jcollinsnw/CANoE/canoe/can_protocol.h

// can_protocol.h
// Shared CAN message layout for the accessory bus.
// Copy this same file into every node's sketch folder so both sides agree.
//
// Bus: 125 kbit/s, standard 11-bit IDs. Low speed gives us noise margin in
// bench mode (open-drain + pull-up) and still runs fine through real
// transceivers in the car. Bump to 250 or 500 kbit/s later if you want.

#pragma once
#include <stdint.h>

// --------------------------------------------------------------
// Message IDs
// --------------------------------------------------------------
#define CAN_ID_RELAY_CMD         0x100  // Switch panel  -> Relay controller
#define CAN_ID_RELAY_STATUS      0x101  // Relay ctrl    -> everyone, periodic
#define CAN_ID_LED_CMD           0x102  // Any node -> target node: [target, mask, state]
#define CAN_ID_LED_STATUS        0x103  // Target node  -> everyone, on change: [node_id, bitmap]
#define CAN_ID_BUZZER_CMD        0x104  // Any node -> target node: [target, cmd, arg0]
                                        //   target: node_id or 0xFF (broadcast)
                                        //   cmd: BUZZER_SEQ_* or BUZZER_CMD_MUTE
                                        //   arg0: seq argument (peer count for BUZZER_SEQ_PEER;
                                        //         1/0 for BUZZER_CMD_MUTE)
#define CAN_ID_SWITCH_EVENT      0x200  // Switch panel  -> everyone, on change
#define CAN_ID_SWITCH_ACK        0x202  // Any non-originating node -> switch panel: [switch_id, event]
#define CAN_ID_ENCODER_EVENT     0x201  // Switch panel  -> everyone: rotary encoder
#define CAN_ID_TELEMETRY         0x300  // Relay ctrl    -> everyone, periodic
#define CAN_ID_ENV_DATA          0x301  // Switch panel  -> everyone, periodic (temp/humidity)
#define CAN_ID_IMU_DATA          0x302  // Viper iface   -> everyone, periodic (accel xyz)
#define CAN_ID_SHAKE_EVENT       0x303  // Viper iface   -> everyone, on detection
#define CAN_ID_ENGINE_DATA       0x304  // RPM node      -> everyone: [rpm_lo, rpm_hi]
#define CAN_ID_GPS_DATA          0x305  // GPS node      -> everyone: [speed_lo, speed_hi, heading_lo, heading_hi, flags]

#define CAN_ID_WBO2_DATA         0x306  // WBO2 node     -> everyone: [afr_lo, afr_hi] (AFR × 100)

#define CAN_ID_ECU_DATA          0x307  // ECU node      -> everyone, 250 ms:
                                        //   [0] mode (0=carb, 1=inject)
                                        //   [1] MAP kPa  (0–255)
                                        //   [2] TPS %    (0–100)
                                        //   [3] CLT °C + 40  (0 = −40°C)
                                        //   [4] IAT °C + 40
                                        //   [5] pw_lo — solenoid duty×100 or inj PW μs (uint16 LE)
                                        //   [6] pw_hi
                                        //   [7] flags: bit0=closed_loop, bit1=enriching,
                                        //              bit2=inj_saturated, bit3=running
#define CAN_ID_ECU_CMD           0x308  // Any node      -> ECU: [cmd, arg0, arg1, arg2]
                                        //   cmd 0x01: set mode   (arg0: 0=carb 1=inject)
                                        //   cmd 0x02: set target AFR×100 (arg1+arg2 = uint16 LE)
                                        //   cmd 0x03: fuel cut   (arg0: 0=off 1=on)
                                        //   cmd 0x04: reset fuel trim
#define CAN_ID_IGNITION_DATA     0x310  // Ignition node -> everyone:
                                        //   [0] coil_cv_lo  (uint16 LE centivolts)
                                        //   [1] coil_cv_hi
                                        //   [2] ign_on      (1 = coil > on-threshold, 0 = below off-threshold)
#define CAN_ID_FUEL_PUMP_STATE   0x311  // Fuel pump node -> everyone:
                                        //   [0] state    (0=PRIME, 1=ARMED, 2=RUNNING)
                                        //   [1] mode     (FuelPumpMode bitmask)
                                        //   [2] reason   (0=none, 1=boot, 2=prime_done, 3=gate_pass,
                                        //                 4=stall, 5=mode_change, 6=re_enable)
                                        //   [3] gates_ok (bit 0=RPM ok, bit 1=COIL ok)

// Node presence heartbeat — every node broadcasts this every 5 s.
// data[0]=node_id, data[1]=peer_count, data[2]=can_ok (0/1)
// The web UI uses data[0] to identify the sender so all nodes share one CAN ID.
#define CAN_ID_NODE_ANNOUNCE     0x0F0

// Boot event — emitted once at the end of setup(), self-echoed back into rx.
// data[0]=node_id. Use TRIG_BOOT() in RULES_DEFAULT_INIT to fire rules on startup.
#define CAN_ID_BOOT_EVENT        0x0F1

// Node capability advertisement — every node broadcasts at boot and on NODE_CAP_REQ.
// data[0]=node_id, data[1]=caps_bitmask, data[2]=switch_count, data[3]=button_count,
// data[4]=led_count, data[5]=relay_count
#define CAN_ID_NODE_CAP          0x0F2
// Node capability request — any node replies with CAN_ID_NODE_CAP.
// data[0]=target_node_id (0xFF = all nodes)
#define CAN_ID_NODE_CAP_REQ      0x0F3

// Reboot command — any node may send; target restarts when its node_id matches or target is 0xFF.
// data[0] = target_node_id (0x01–0x04 for a specific node, 0xFF = all nodes)
#define CAN_ID_REBOOT_CMD        0x0F5

// Unified error event — any module may emit to signal an abnormal condition.
// Receivers (buzzer, LEDs, Cardputer, web UI) react based on severity.
// data[0] = source_node_id
// data[1] = error_code (ERR_*)
// data[2] = severity (ERR_SEV_*)
// data[3] = target_node_id (0xFF = all nodes should alert; specific = only that node alerts)
// data[4] = flags (ERR_FLAG_*)
// data[5] = arg0 (error-specific context)
// data[6] = arg1
// data[7] = arg2
#define CAN_ID_ERROR_EVENT       0x0F6

// Bus error event — emitted by any node that detects a CAN error condition.
// Sent on both transports (ESP-NOW carries it even if wired CAN is failing).
// data[0]=node_id, data[1]=error_code (BUS_ERR_*), data[2]=tx_err_cnt, data[3]=rx_err_cnt
#define CAN_ID_BUS_ERROR         0x0F4

// Bus error codes for CAN_ID_BUS_ERROR data[1]
#define BUS_ERR_BUS_OFF          0x01  // TWAI entered bus-off state; recovery initiated
#define BUS_ERR_ERROR_PASSIVE    0x02  // TEC or REC >= 96 (error passive threshold)
#define BUS_ERR_TX_FAIL          0x03  // 5+ consecutive TX failures (no ACK)
#define BUS_ERR_RX_OVERFLOW      0x04  // RX buffer overrun — frames were silently dropped

// --------------------------------------------------------------
// ERROR_EVENT severity levels
// --------------------------------------------------------------
#define ERR_SEV_INFO             0x00  // transient, usually self-resolving (e.g. sensor glitch)
#define ERR_SEV_WARNING          0x01  // degraded operation, needs attention soon
#define ERR_SEV_CRITICAL         0x02  // hardware damage risk or safety system engaged
#define ERR_SEV_EMERGENCY        0x03  // system inoperable or imminent danger

// ERROR_EVENT flags (data[4])
#define ERR_FLAG_ACTIVE          0x01  // 1 = fault active; 0 = fault cleared
#define ERR_FLAG_AUDIBLE         0x02  // request audible alert on receiver
#define ERR_FLAG_VISUAL          0x04  // request visual alert (LED flash / screen)
#define ERR_FLAG_LATCHING        0x08  // stays active until explicit clear frame received

// ERROR_EVENT error codes (data[1])
// Grouped by subsystem: 0x01–0x1F bus/transport, 0x20–0x3F power,
//                       0x40–0x5F engine/fuel, 0x60–0x7F sensors,
//                       0x80–0x9F comms, 0xA0+ application
// -- Bus / transport --
#define ERR_CAN_INIT_FAIL        0x01  // CAN driver could not start
#define ERR_CAN_BUS_OFF          0x02  // TWAI bus-off state
#define ERR_CAN_ERROR_PASSIVE    0x03  // TWAI error-passive threshold
#define ERR_CAN_TX_FAIL          0x04  // repeated TX failures
#define ERR_CAN_RX_OVERFLOW      0x05  // RX ring overflow, frames lost
#define ERR_ESPNOW_INIT_FAIL     0x06  // ESP-NOW could not initialize
// -- Power --
#define ERR_LOW_VOLTAGE          0x20  // battery below threshold; arg0 = which bat (0=primary, 1=aux)
#define ERR_RELAY_WATCHDOG       0x21  // relay forced off by watchdog; arg0 = relay index
// -- Engine / fuel --
#define ERR_FUEL_PUMP_STALL      0x40  // fuel pump FSM cut (RUNNING→ARMED); arg0 = stall reason
#define ERR_INJECTOR_SATURATED   0x41  // injector duty >95%; arg0 = duty % clamped
#define ERR_WBO2_SENSOR_FAULT    0x42  // WBO2 reading implausible (0V or 5V); arg0 = raw ADC byte
#define ERR_ECU_SENSOR_FAULT     0x43  // NTC/MAP/TPS out of range; arg0 = sensor id (0=MAP,1=TPS,2=CLT,3=IAT)
// -- Sensors --
#define ERR_MPU6050_FAIL         0x60  // IMU not responding
#define ERR_DHT22_FAIL           0x61  // temp/humidity read failed; arg0 = consecutive fail count
#define ERR_GPS_NO_FIX           0x62  // GPS has no fix (INFO-level, self-resolving)
// -- Comms --
#define ERR_SWITCH_ACK_TIMEOUT   0x80  // switch event not ACKed after retries; arg0 = switch_id
#define ERR_RELAY_CONFIRM_TIMEOUT 0x81 // RELAY_STATUS not received after CMD; arg0 = relay mask
#define ERR_WIFI_CREDS_REJECTED  0x82  // blob credential validation failed; arg0 = key (SSID/PASS/PMK/LMK)
#define ERR_OTA_FAILED           0x83  // OTA upload failed
#define ERR_MQTT_CONNECT_FAIL    0x84  // MQTT broker unreachable
// -- Application --
#define ERR_NVS_CORRUPT          0xA0  // NVS read returned implausible value; arg0 = context id

// Capability bits for CAN_ID_NODE_CAP data[1]
#define NODE_CAP_RELAY    0x01   // has relay outputs
#define NODE_CAP_SWITCHES 0x02   // has switch/button inputs
#define NODE_CAP_VIPER    0x04   // has Viper alarm interface
#define NODE_CAP_LEDS     0x08   // has CAN-controllable LEDs
#define NODE_CAP_RULES    0x10   // has rules engine

// Generic chunked blob write protocol.
// One transfer = N BLOB_WRITE frames + one BLOB_COMMIT frame.
// Multiple (ns, key) transfers may interleave; each has its own RX slot.
// Self-echoed frames are ignored on the receiving side.
//
// BLOB_WRITE  [0]=target [1]=ns [2]=key [3]=chunk_idx [4-7]=data (4 bytes)
// BLOB_COMMIT [0]=target [1]=ns [2]=key [3]=len_lo    [4]=len_hi [5]=flags
#define CAN_ID_BLOB_WRITE    0x410
#define CAN_ID_BLOB_COMMIT   0x411

// Blob namespaces
#define BLOB_NS_WIFI         0x01   // WiFi + ESP-NOW credentials
#define BLOB_NS_RULES        0x02   // Rules engine: key = slot index (0..MAX_RULES-1),
                                    //   payload = 12-byte CanRule (zeroed = clear slot).
                                    //   key 0xFE = factory reset (any 1-byte payload).

// Keys within BLOB_NS_WIFI
#define BLOB_KEY_SSID        0x01   // AP SSID string, max 32 bytes
#define BLOB_KEY_PASS        0x02   // AP password string, max 63 bytes (0 len = open)
#define BLOB_KEY_PMK         0x03   // ESP-NOW PMK, exactly 16 bytes
#define BLOB_KEY_LMK         0x04   // ESP-NOW LMK, exactly 16 bytes

// Blob commit flags (BLOB_COMMIT data[5])
#define BLOB_FLAG_PERSIST    0x01   // write to NVS after commit
#define BLOB_FLAG_REBOOT     0x02   // restart node after applying

// Config-over-CAN — change behavior at runtime without reflashing.
#define CAN_ID_CONFIG_WRITE      0x400
#define CAN_ID_CONFIG_READ_REQ   0x401
#define CAN_ID_CONFIG_READ_RESP  0x402
#define CAN_ID_CONFIG_SAVE       0x403

// Peripheral commands.
#define CAN_ID_LCD_CMD           0x500  // Anyone -> switch_panel: write LCD text

// Viper alarm interface node (NODE_ID 0x03)
#define CAN_ID_VIPER_CMD         0x510  // Any node -> viper_interface: data[0] = VIPER_CMD_*
#define CAN_ID_VIPER_STATUS      0x511  // viper_interface -> everyone: data[0..4] = raw 5-byte alarm packet

// Channel capability advertisement — OBD2-style query/response.
// Any node (or app) sends CHAN_CAP_REQ; nodes that have CHAN_CAPS_INIT respond
// with one CHAN_CAP frame per channel they publish.
//
// CHAN_CAP_REQ [0]=target_node_id (0xFF = all)
// CHAN_CAP     [0]=node_id [1]=chan_id [2]=src_can_id_lo [3]=src_can_id_hi
//              [4]=byte_offset [5]=encoding [6]=int_offset (int8) [7]=valid_spec
#define CAN_ID_CHAN_CAP_REQ      0x320
#define CAN_ID_CHAN_CAP          0x321

// Standard channel IDs (CHAN_CAP data[1]) — identifies the physical quantity.
// These are stable across firmware versions; new sensors get new IDs.
#define CHAN_ID_RPM              0x01   // engine RPM (rpm)
#define CHAN_ID_TPS              0x02   // throttle position (%)
#define CHAN_ID_MAP              0x03   // manifold absolute pressure (kPa)
#define CHAN_ID_CLT              0x04   // coolant temperature (°C)
#define CHAN_ID_IAT              0x05   // intake air temperature (°C)
#define CHAN_ID_AFR              0x06   // air/fuel ratio (:1)
#define CHAN_ID_SPEED            0x07   // vehicle speed (mph)
#define CHAN_ID_VBAT             0x08   // main battery voltage (V)
#define CHAN_ID_VBAT2            0x09   // auxiliary battery voltage (V)

// Encoding byte (CHAN_CAP data[5]) — packed field describing how to decode the raw bytes.
//   bits [7:6] — data type
#define CHAN_ENC_U8              0x00   // uint8, single byte at byte_offset
#define CHAN_ENC_U16LE           0x40   // uint16 little-endian, two bytes at byte_offset
#define CHAN_ENC_I8              0x80   // int8, single byte
#define CHAN_ENC_I16LE           0xC0   // int16 little-endian
//   bits [5:4] — scale divisor applied after raw → double conversion
#define CHAN_SCALE_1             0x00   // value / 1
#define CHAN_SCALE_10            0x10   // value / 10
#define CHAN_SCALE_100           0x20   // value / 100
#define CHAN_SCALE_1000          0x30   // value / 1000
//   modifier bits
#define CHAN_HAS_OFFSET          0x08   // add int_offset (data[6], int8) to scaled result
#define CHAN_HAS_VALID           0x04   // check a specific bit before accepting value
                                        //   data[7] valid_spec: bits[7:4]=byte_idx, bits[3:0]=bit_idx
#define CHAN_SKIP_ZERO           0x02   // treat decoded value of 0.0 as "not available" (return nil)

// Compact channel definition — one row per channel a node publishes.
// Stored as a static const array (CHAN_CAPS_INIT) in each node config.
struct CanChanDef {
    uint8_t  chan_id;      // CHAN_ID_* above
    uint16_t src_can_id;   // CAN ID of the frame that carries this channel
    uint8_t  byte_offset;  // first byte index within that frame (0-7)
    uint8_t  encoding;     // CHAN_ENC_* | CHAN_SCALE_* | modifier flags
    int8_t   int_offset;   // signed offset added after scaling (0 if !CHAN_HAS_OFFSET)
    uint8_t  valid_spec;   // (byte_idx<<4)|bit_idx for valid-bit check (0 if !CHAN_HAS_VALID)
};

// Usage: CHAN_DEF(CHAN_ID_RPM, CAN_ID_ENGINE_DATA, 0, CHAN_ENC_U16LE|CHAN_SCALE_1, 0, 0)
#define CHAN_DEF(chan, src, off, enc, ioff, vspec) \
    { (chan), (src), (off), (enc), (ioff), (vspec) }

// Viper command codes for CAN_ID_VIPER_CMD data[0]
#define VIPER_CMD_LOCK           0x01   // Arm / lock doors
#define VIPER_CMD_UNLOCK         0x02   // Disarm / unlock doors
#define VIPER_CMD_REMOTE_START   0x03   // Remote start engine

// Buzzer sequence/command codes for CAN_ID_BUZZER_CMD data[1]
#define BUZZER_SEQ_ALERT          0x01  // 3-beep urgent warning
#define BUZZER_SEQ_CAN_UP         0x02  // rising 3-tone: link restored
#define BUZZER_SEQ_CAN_DOWN       0x03  // 2 low pulses: link lost
#define BUZZER_SEQ_STARTUP        0x04  // boot jingle
#define BUZZER_SEQ_PEER           0x05  // peer-count tone; arg0 = count
#define BUZZER_SEQ_WIFI_CONNECT   0x06  // ascending 2-note chime
#define BUZZER_SEQ_WIFI_DISCONNECT 0x07 // descending 2-note chime
#define BUZZER_SEQ_RELAY_ON       0x10  // relay-on sound
#define BUZZER_SEQ_RELAY_OFF      0x11  // relay-off sound
#define BUZZER_SEQ_ALL_OFF        0x12  // all-relays-off sound
#define BUZZER_SEQ_FUEL_PUMP_OFF  0x13  // fuel pump safety cut — 4 urgent low/high pulses
#define BUZZER_CMD_MUTE           0x20  // arg0: 1 = mute, 0 = unmute

#define CFG_TARGET_VIPER         0x03
#define CFG_TARGET_ECU           0x04

// --------------------------------------------------------------
// CAN_ID_RELAY_CMD (2 bytes)
//   data[0] : mask   — bit N set = "act on relay N"  (bit 0 = relay 1, ... bit 5 = relay 6)
//   data[1] : state  — bit N is the desired state of relay N (1 = on, 0 = off)
// Only relays whose mask bit is 1 are changed. Others keep their current state.
// --------------------------------------------------------------

// --------------------------------------------------------------
// CAN_ID_RELAY_STATUS  (1 byte)    — bit 0 = relay 1 on/off, etc. ~5 Hz.
// CAN_ID_SWITCH_EVENT  (2 bytes)   — [switch_id, SwitchEvent]. On change.
// CAN_ID_ENCODER_EVENT (2 bytes)   — [EncoderEvent, count]. On change.
// CAN_ID_TELEMETRY     (8 bytes)   — vbat_cv, ibatt_da, vsolar_cv, flags, _
// CAN_ID_LCD_CMD       (2-8 bytes) — [row, col, char...] or [0xFF] to clear.
// --------------------------------------------------------------

// --------------------------------------------------------------
// Switch events — published on every change.
// --------------------------------------------------------------
enum SwitchEvent : uint8_t {
  SW_RELEASE       = 0,
  SW_PRESS         = 1,
  SW_LONG_PRESS    = 2,
  SW_DOUBLE_PRESS  = 3,
};

// Encoder events — published on CAN_ID_ENCODER_EVENT.
// data[0] = EncoderEvent, data[1] = step count (rotation events only).
enum EncoderEvent : uint8_t {
  ENC_ROTATE_CW   = 0,  // clockwise detent(s); data[1] = count
  ENC_ROTATE_CCW  = 1,  // counter-clockwise;   data[1] = count
  ENC_PRESS       = 2,  // push-button pressed
  ENC_RELEASE     = 3,  // push-button released
  ENC_LONG_PRESS  = 4,  // held longer than LONG_PRESS_MS
};

// --------------------------------------------------------------
// Rules engine — any CAN frame → any CAN action, stored in NVS.
// Rules are evaluated on every received frame; the first matching
// condition fires its action. trig_id == 0 means the slot is empty.
//
// Condition matching (c0 and c1 are independent; c*_mask == 0 skips):
//   (frame.data[c*_byte] & c*_mask) == (c*_val & c*_mask)
// --------------------------------------------------------------
enum RuleActionKind : uint8_t {
  RULE_ACT_NONE         = 0,   // slot disabled
  RULE_ACT_RELAY_TOGGLE = 1,   // arg0 = relay idx (0-5)
  RULE_ACT_RELAY_ON     = 2,   // arg0 = relay idx
  RULE_ACT_RELAY_OFF    = 3,   // arg0 = relay idx
  RULE_ACT_ALL_OFF      = 4,   // all relays off
  RULE_ACT_RELAY_SCENE  = 5,   // arg0 = 6-bit relay bitmap
  RULE_ACT_LED_ON       = 6,   // arg0 = target node_id, arg1 = led index
  RULE_ACT_LED_OFF      = 7,   // arg0 = target node_id, arg1 = led index
  RULE_ACT_WIFI_ENABLE  = 8,   // arg0 = target node_id
  RULE_ACT_WIFI_DISABLE = 9,   // arg0 = target node_id
  RULE_ACT_VIPER_CMD    = 10,  // arg0 = VIPER_CMD_*
  RULE_ACT_MENU_SELECT      = 11,  // short-press menu select (no-op when menu closed)
  RULE_ACT_MENU_ENTER       = 12,  // long-press: enter menu or confirm action
  RULE_ACT_RELAY_TIMED_OFF  = 13,  // arg0 = relay idx (0-5), arg1 = seconds (1-255)
  RULE_ACT_LED_FLASH        = 14,  // arg0 = target node_id, arg1 = led idx, arg2 = period (×50ms half-period)
  RULE_ACT_BUZZER_ALERT     = 15,  // play a 3-beep warning on the local buzzer (no-op without ENABLE_BUZZER)
  RULE_ACT_BUZZER_PLAY      = 16,  // send BUZZER_CMD: arg0=target, arg1=BUZZER_SEQ_*, arg2=seq_arg
  RULE_ACT_FUEL_PUMP_SAFETY = 17,  // arg0 = FuelPumpMode bitmask:
                                   //   bit 0 (0x01) = RPM gate
                                   //   bit 1 (0x02) = COIL gate
                                   //   (bit 2 reserved for OIL_PRESSURE)
                                   //   0 = off (pump forced on), 1 = RPM, 2 = COIL, 3 = BOTH (AND)
                                   // local-only, RAM (resets to FUEL_PUMP_DEFAULT_MODE on reboot)
};

// Fuel-pump safety mode bitmask. ACT_FUEL_PUMP_SAFETY_* and the
// CFG_KEY_FUEL_PUMP_SAFETY config-write payload all use these values.
#define FP_MODE_OFF        0  // both gates disabled, pump forced on
#define FP_MODE_RPM        1  // RPM gate only
#define FP_MODE_COIL       2  // COIL gate only
#define FP_MODE_BOTH       3  // RPM AND COIL (default)

struct CanRule {
  uint16_t trig_id;   // CAN frame ID to watch; 0 = slot disabled
  uint8_t  c0_byte;   // data byte index for condition 0
  uint8_t  c0_val;    // expected value (after masking)
  uint8_t  c0_mask;   // AND mask; 0x00 = skip this condition entirely
  uint8_t  c1_byte;   // data byte index for condition 1
  uint8_t  c1_val;
  uint8_t  c1_mask;   // 0x00 = skip
  uint8_t  action;    // RuleActionKind
  uint8_t  arg0;
  uint8_t  arg1;
  uint8_t  arg2;
};  // 12 bytes — fits cleanly in NVS putBytes

// --------------------------------------------------------------
// Trigger macros — expand to the CanRule trigger fields:
//   trig_id, c0_byte, c0_val, c0_mask, c1_byte, c1_val, c1_mask
// --------------------------------------------------------------
// Switch events (SWITCH_EVENT: data[0]=sw_idx, data[1]=SwitchEvent)
#define TRIG_SW_PRESS(idx)    CAN_ID_SWITCH_EVENT, 0, (idx), 0xFF, 1, SW_PRESS,      0xFF
#define TRIG_SW_RELEASE(idx)  CAN_ID_SWITCH_EVENT, 0, (idx), 0xFF, 1, SW_RELEASE,    0xFF
#define TRIG_SW_LONG(idx)     CAN_ID_SWITCH_EVENT, 0, (idx), 0xFF, 1, SW_LONG_PRESS, 0xFF

// Relay status (RELAY_STATUS: data[0] = relay bitmap at 5 Hz)
// These fire every status broadcast while the condition holds.
#define TRIG_RELAY_BIT_ON(n)  CAN_ID_RELAY_STATUS, 0, (1<<(n)), (1<<(n)), 0, 0, 0x00
#define TRIG_RELAY_BIT_OFF(n) CAN_ID_RELAY_STATUS, 0, 0x00,     (1<<(n)), 0, 0, 0x00

// Relay command (RELAY_CMD: data[0]=mask, data[1]=state — fires only on changes)
#define TRIG_RELAY_CMD_ON(n)  CAN_ID_RELAY_CMD, 0, (1<<(n)), (1<<(n)), 1, (1<<(n)), (1<<(n))
#define TRIG_RELAY_CMD_OFF(n) CAN_ID_RELAY_CMD, 0, (1<<(n)), (1<<(n)), 1, 0x00,     (1<<(n))

// Match any frame with a given ID (no byte conditions)
#define TRIG_ANY(id)          (id), 0, 0, 0x00, 0, 0, 0x00

// Boot event — fires once at startup on the node that emitted it (self-echo).
// data[0] = node_id; matches only this node's own boot event.
#define TRIG_BOOT()           CAN_ID_BOOT_EVENT, 0, NODE_ID, 0xFF, 0, 0, 0x00

// Bus error — fires when any node broadcasts CAN_ID_BUS_ERROR (any error code).
#define TRIG_BUS_ERROR()      CAN_ID_BUS_ERROR, 0, 0, 0x00, 0, 0, 0x00

// Error event — fires on any ERROR_EVENT frame. Use c0/c1 to filter by severity or code.
// Example: TRIG_ERROR_CRITICAL() fires only on severity >= CRITICAL.
#define TRIG_ERROR_EVENT()           CAN_ID_ERROR_EVENT, 0, 0, 0x00, 0, 0, 0x00
#define TRIG_ERROR_CRITICAL()        CAN_ID_ERROR_EVENT, 2, ERR_SEV_CRITICAL, 0xFE, 0, 0, 0x00
#define TRIG_ERROR_EMERGENCY()       CAN_ID_ERROR_EVENT, 2, ERR_SEV_EMERGENCY, 0xFF, 0, 0, 0x00

// CAN OK — fires when a NODE_ANNOUNCE with can_ok=1 arrives; use to auto-clear error indicators.
// data[2] = can_ok (1 = bus healthy); matches any node announcing itself as healthy.
#define TRIG_CAN_OK()         CAN_ID_NODE_ANNOUNCE, 2, 0x01, 0xFF, 0, 0, 0x00

// --------------------------------------------------------------
// Action macros — expand to the CanRule action fields:
//   action, arg0, arg1, arg2
// --------------------------------------------------------------
#define ACT_RELAY_TOGGLE(r)    RULE_ACT_RELAY_TOGGLE, (r),    0,      0
#define ACT_RELAY_ON(r)        RULE_ACT_RELAY_ON,     (r),    0,      0
#define ACT_RELAY_OFF(r)       RULE_ACT_RELAY_OFF,    (r),    0,      0
#define ACT_ALL_OFF()          RULE_ACT_ALL_OFF,      0,      0,      0
#define ACT_RELAY_SCENE(bmap)  RULE_ACT_RELAY_SCENE,  (bmap), 0,      0
#define ACT_LED_ON(node, led)  RULE_ACT_LED_ON,       (node), (led),  0
#define ACT_LED_OFF(node, led) RULE_ACT_LED_OFF,      (node), (led),  0
#define ACT_WIFI_ENABLE(node)  RULE_ACT_WIFI_ENABLE,  (node), 0,      0
#define ACT_WIFI_DISABLE(node) RULE_ACT_WIFI_DISABLE, (node), 0,      0
#define ACT_VIPER(cmd)         RULE_ACT_VIPER_CMD,    (cmd),  0,      0
#define ACT_MENU_SELECT()             RULE_ACT_MENU_SELECT,     0,     0, 0
#define ACT_MENU_ENTER()              RULE_ACT_MENU_ENTER,      0,     0, 0
#define ACT_RELAY_TIMED_OFF(r, sec)   RULE_ACT_RELAY_TIMED_OFF, (r), (sec), 0
#define ACT_LED_FLASH(node, led, per) RULE_ACT_LED_FLASH,        (node), (led), (per)
#define ACT_BUZZER_ALERT()                    RULE_ACT_BUZZER_ALERT, 0, 0, 0
#define ACT_BUZZER_PLAY(target, seq)          RULE_ACT_BUZZER_PLAY, (target), (seq), 0
#define ACT_BUZZER_PLAY_ARG(target, seq, arg) RULE_ACT_BUZZER_PLAY, (target), (seq), (arg)
#define ACT_FUEL_PUMP_SAFETY(mode)     RULE_ACT_FUEL_PUMP_SAFETY, (mode), 0, 0
#define ACT_FUEL_PUMP_SAFETY_DISABLE   RULE_ACT_FUEL_PUMP_SAFETY, FP_MODE_OFF,  0, 0
#define ACT_FUEL_PUMP_SAFETY_RPM_ONLY  RULE_ACT_FUEL_PUMP_SAFETY, FP_MODE_RPM,  0, 0
#define ACT_FUEL_PUMP_SAFETY_COIL_ONLY RULE_ACT_FUEL_PUMP_SAFETY, FP_MODE_COIL, 0, 0
#define ACT_FUEL_PUMP_SAFETY_BOTH      RULE_ACT_FUEL_PUMP_SAFETY, FP_MODE_BOTH, 0, 0
// Kept for backwards compatibility — equivalent to RPM-only (the only gate
// that existed before COIL was added).
#define ACT_FUEL_PUMP_SAFETY_ENABLE    RULE_ACT_FUEL_PUMP_SAFETY, FP_MODE_RPM,  0, 0

// Convenience: wrap a trigger + action pair into a CanRule initialiser.
// Usage: RULE(TRIG_SW_PRESS(0), ACT_RELAY_TOGGLE(0))
#define RULE(trig, act)  { trig, act }

// --------------------------------------------------------------
// CONFIG PROTOCOL
// Every config frame carries an 8-bit `target` so you can address a
// specific node type, or broadcast to all.
// --------------------------------------------------------------
#define CFG_TARGET_SWITCH_PANEL   0x01
#define CFG_TARGET_RELAY_CTRL     0x02
#define CFG_TARGET_BROADCAST      0xFF

// Keys — what piece of config is being addressed.
//   Relay controller side:
#define CFG_KEY_NODE_ID           0x01   // data[4] = new node_id (0x01-0xFE); node restarts. Broadcast target NOT accepted.
#define CFG_KEY_RELAY_MAX_ON_MS   0x20   // per-relay safety auto-off (0 = no limit)
#define CFG_KEY_RPM_REDLINE       0x40   // RPM redline for display widget; arg2_lo/hi = RPM uint16
#define CFG_KEY_ECU_MODE          0x51   // 0=carb, 1=inject; arg[4]=value, flags bit0=persist
#define CFG_KEY_ECU_TARGET_AFR    0x52   // target AFR × 100; arg2_lo/hi = uint16
#define CFG_KEY_ECU_BASE_PW       0x53   // base pulse width μs at 100% VE, 100 kPa; arg2_lo/hi
#define CFG_KEY_FUEL_PUMP_SAFETY  0x61   // data[4] = FuelPumpMode bitmask (FP_MODE_*); RAM-only, resets to FUEL_PUMP_DEFAULT_MODE on reboot
//   Any node:
#define CFG_KEY_WIFI_ENABLED      0x30   // legacy: sets both ap_en and espnow_en; node restarts
#define CFG_KEY_AP_ENABLED        0x31   // data[4]=0/1 — enable/disable SoftAP + web server; restarts
#define CFG_KEY_ESPNOW_ENABLED    0x32   // data[4]=0/1 — enable/disable ESP-NOW radio; restarts
#define CFG_KEY_BT_ENABLED        0x33   // data[4]=0/1 — enable/disable BLE; saves to NVS; node restarts
#define CFG_KEY_BT_ADVERTISING    0x34   // data[4]=0/1 — start/stop BLE advertising; runtime only, no restart

// Save actions (for CAN_ID_CONFIG_SAVE data[1]):
#define CFG_SAVE_COMMIT           0x01   // flush RAM config to NVS
#define CFG_SAVE_RELOAD           0x02   // drop RAM changes, reload from NVS
#define CFG_SAVE_FACTORY_RESET    0x03   // clear NVS, revert to compiled defaults

// CAN_ID_CONFIG_WRITE (8 bytes)
//   [0] target
//   [1] key
//   [2] index     (switch id, relay id, etc.)
//   [3] kind      (unused / reserved)
//   [4] arg
//   [5] arg2_lo
//   [6] arg2_hi
//   [7] flags     (bit 0 = persist to NVS immediately after applying)
//
// CAN_ID_CONFIG_READ_REQ (3 bytes)
//   [0] target
//   [1] key
//   [2] index     (0xFF = request all indices for this key)
//
// CAN_ID_CONFIG_READ_RESP (8 bytes)
//   Same layout as CAN_ID_CONFIG_WRITE (flags byte unused).
//
// CAN_ID_CONFIG_SAVE (2 bytes)
//   [0] target
//   [1] action    (CFG_SAVE_* above)
// --------------------------------------------------------------

// Little-endian int16 pack/unpack helpers
static inline void pack_i16(uint8_t *buf, int16_t v) {
  buf[0] = (uint8_t)(v & 0xFF);
  buf[1] = (uint8_t)((v >> 8) & 0xFF);
}
static inline int16_t unpack_i16(const uint8_t *buf) {
  return (int16_t)(buf[0] | (buf[1] << 8));
}
static inline void pack_u16(uint8_t *buf, uint16_t v) {
  buf[0] = (uint8_t)(v & 0xFF);
  buf[1] = (uint8_t)((v >> 8) & 0xFF);
}
static inline uint16_t unpack_u16(const uint8_t *buf) {
  return (uint16_t)(buf[0] | (buf[1] << 8));
}
