jcollinsnw/CANoE/canoe/bus.cpp

// bus.cpp — see bus.h

#include <Arduino.h>
#include <WiFi.h>
#include <esp_now.h>
#include <esp_wifi.h>
#include "driver/twai.h"
#include "node_config.h"
#include "bus.h"
#include "can_protocol.h"
#include "mod_error.h"

#ifdef ENABLE_LCD
#include "mod_lcd.h"
#endif

// --------------------------------------------------------------
// Wire format for ESP-NOW. Magic filters out random broadcasts
// from other projects sharing the airwaves.
// --------------------------------------------------------------
static const uint32_t WIFI_FRAME_MAGIC = 0xCA5BABE7;
struct __attribute__((packed)) WifiFrame {
  uint32_t magic;
  uint8_t  node_id;
  uint16_t seq;
  uint32_t can_id;
  uint8_t  dlc;
  uint8_t  data[8];
};

// --------------------------------------------------------------
// State
// --------------------------------------------------------------
static uint8_t g_node_id = 0;
static uint16_t g_tx_seq = 0;
static BusTxMode g_tx_mode = BUS_TX_CAN_WIFI;
static bool g_wifi_enabled = false;

static uint32_t g_last_can_tx_ok  = 0;
static uint32_t g_last_can_rx     = 0;
static uint32_t g_last_wifi_rx    = 0;
static uint16_t g_tx_fail_streak  = 0;
static bool     g_twai_was_ok     = false;
static uint8_t  g_last_error_code = 0;    // last BUS_ERR_* emitted; 0 = healthy
static uint32_t g_last_tx_failed  = 0;    // cumulative tx_failed_count at last check
static uint32_t g_last_rx_missed  = 0;    // cumulative rx_missed_count at last check

// Encrypted unicast peers — added dynamically when we first hear from each node.
// ESP-NOW broadcast (FF:FF:FF:FF:FF:FF) cannot be encrypted; unicast can.
// Frames are sent both unicast (encrypted) to known peers and broadcast (unencrypted)
// for initial discovery. Dedup by (node_id, seq) handles the overlap on the RX side.
#define MAX_ENC_PEERS 6
static uint8_t g_enc_macs[MAX_ENC_PEERS][6];
static uint8_t g_enc_count = 0;

static uint8_t g_espnow_pmk[16] = {};
static uint8_t g_espnow_lmk[16] = {};
static bool    g_espnow_keys_set = false;

static bool enc_peer_known(const uint8_t* mac) {
  for (int i = 0; i < g_enc_count; i++)
    if (memcmp(g_enc_macs[i], mac, 6) == 0) return true;
  return false;
}

static void enc_peer_add(const uint8_t* mac) {
  if (enc_peer_known(mac) || g_enc_count >= MAX_ENC_PEERS) return;
  esp_now_peer_info_t p = {};
  memcpy(p.peer_addr, mac, 6);
  p.channel = 0;
  p.encrypt = true;
  memcpy(p.lmk, g_espnow_keys_set ? g_espnow_lmk : (const uint8_t*)ESPNOW_LMK, 16);
  if (esp_now_add_peer(&p) == ESP_OK) {
    memcpy(g_enc_macs[g_enc_count++], mac, 6);
    Serial.printf("[bus] encrypted peer added (%02X:%02X:%02X:%02X:%02X:%02X)\n",
                  mac[0],mac[1],mac[2],mac[3],mac[4],mac[5]);
  }
}

static bus_observer_t g_observer = nullptr;

// Per-peer activity tracking — used to report connect/disconnect counts.
// Slot node_id==0 means empty. Timeout matches bus_wifi_seen_peer() window.
static const uint32_t PEER_TIMEOUT_MS = 12000; // 2.4× announce interval; node must miss 2 beats
struct PeerEntry { uint8_t node_id; uint32_t last_seen_ms; };
static PeerEntry g_peers[8] = {};

static void peer_touch(uint8_t node_id) {
  uint32_t now = millis();
  for (int i = 0; i < 8; i++) {
    if (g_peers[i].node_id == node_id) { g_peers[i].last_seen_ms = now; return; }
  }
  for (int i = 0; i < 8; i++) {
    if (!g_peers[i].node_id || (now - g_peers[i].last_seen_ms) >= PEER_TIMEOUT_MS) {
      g_peers[i] = {node_id, now}; return;
    }
  }
}

// Dedup cache for (node_id, seq) pairs seen in the last ~2 seconds
struct DedupEntry { uint8_t node_id; uint16_t seq; uint32_t t_ms; };
static const int DEDUP_SIZE = 64;
static DedupEntry g_dedup[DEDUP_SIZE];

static bool dedup_seen_or_record(uint8_t node_id, uint16_t seq) {
  uint32_t now = millis();
  int free_idx = -1;
  for (int i = 0; i < DEDUP_SIZE; i++) {
    if (g_dedup[i].t_ms && (now - g_dedup[i].t_ms) > 2000) g_dedup[i].t_ms = 0;
    if (g_dedup[i].t_ms && g_dedup[i].node_id == node_id && g_dedup[i].seq == seq) return true;
    if (!g_dedup[i].t_ms && free_idx < 0) free_idx = i;
  }
  if (free_idx >= 0) g_dedup[free_idx] = {node_id, seq, now ? now : 1};
  return false;
}

// Ring buffer of received frames (from either transport)
static const int RX_RING_SIZE = 32;
static BusFrame g_ring[RX_RING_SIZE];
static volatile int g_ring_head = 0;
static volatile int g_ring_tail = 0;

static void ring_push(const BusFrame& f) {
  int next = (g_ring_head + 1) % RX_RING_SIZE;
  if (next == g_ring_tail) g_ring_tail = (g_ring_tail + 1) % RX_RING_SIZE; // overwrite oldest
  g_ring[g_ring_head] = f;
  g_ring_head = next;
}

// --------------------------------------------------------------
// ESP-NOW callbacks
// --------------------------------------------------------------
// arduino-esp32 v3.x changed the ESP-NOW receive callback signature.
#if defined(ESP_ARDUINO_VERSION) && ESP_ARDUINO_VERSION >= ESP_ARDUINO_VERSION_VAL(3, 0, 0)
static void on_espnow_recv(const esp_now_recv_info_t* recv_info, const uint8_t* data, int len) {
  const uint8_t* sender_mac = recv_info ? recv_info->src_addr : nullptr;
#else
static void on_espnow_recv(const uint8_t* sender_mac, const uint8_t* data, int len) {
#endif
  if (len != sizeof(WifiFrame)) return;
  WifiFrame f;
  memcpy(&f, data, sizeof(f));
  if (f.magic != WIFI_FRAME_MAGIC) return;
  if (f.node_id == g_node_id) return; // our own broadcast coming back
  if (sender_mac) enc_peer_add(sender_mac); // upgrade to encrypted unicast on first contact
  if (dedup_seen_or_record(f.node_id, f.seq)) return;
  g_last_wifi_rx = millis();
  peer_touch(f.node_id);

  BusFrame b = {};
  b.id = f.can_id;
  b.dlc = f.dlc;
  memcpy(b.data, f.data, 8);
  strncpy(b.source, "wifi", sizeof(b.source));
  ring_push(b);
  if (g_observer) g_observer(b, /*outbound=*/false);
}

// --------------------------------------------------------------
// Public API
// --------------------------------------------------------------
void bus_init(uint8_t node_id) {
  g_node_id = node_id;
  memset(g_dedup, 0, sizeof(g_dedup));
  g_ring_head = g_ring_tail = 0;

  // WiFi must be initialized (by webui_init) before esp_now_init.
  if (esp_now_init() != ESP_OK) {
    Serial.println("[bus] esp_now_init failed");
    error_raise_local(ERR_ESPNOW_INIT_FAIL, ERR_SEV_WARNING);
    return;
  }
  esp_now_set_pmk(g_espnow_keys_set ? g_espnow_pmk : (const uint8_t*)ESPNOW_PMK);
  esp_now_register_recv_cb(on_espnow_recv);

  esp_now_peer_info_t peer = {};
  memset(peer.peer_addr, 0xFF, 6); // broadcast MAC — encryption not supported on broadcast
  peer.channel = 0;                // follow current WiFi channel
  peer.encrypt = false;
  esp_now_add_peer(&peer);

  g_wifi_enabled = true;
  Serial.printf("[bus] ready (wifi+can), node_id=0x%02X\n", node_id);
}

void bus_init_no_ap(uint8_t node_id) {
  g_node_id = node_id;
  memset(g_dedup, 0, sizeof(g_dedup));
  g_ring_head = g_ring_tail = 0;

  // Start WiFi in STA mode so the radio is up for ESP-NOW without launching a SoftAP.
  // Channel must be fixed manually — without an AP association there is no automatic
  // channel negotiation and peers need to agree on the same channel (6).
  WiFi.mode(WIFI_STA);
  WiFi.disconnect(false);
  esp_wifi_set_channel(6, WIFI_SECOND_CHAN_NONE);

  if (esp_now_init() != ESP_OK) {
    Serial.println("[bus] esp_now_init failed (no-ap mode)");
    error_raise_local(ERR_ESPNOW_INIT_FAIL, ERR_SEV_WARNING);
    return;
  }
  esp_now_set_pmk(g_espnow_keys_set ? g_espnow_pmk : (const uint8_t*)ESPNOW_PMK);
  esp_now_register_recv_cb(on_espnow_recv);

  esp_now_peer_info_t peer = {};
  memset(peer.peer_addr, 0xFF, 6);
  peer.channel = 0;
  peer.encrypt = false;
  esp_now_add_peer(&peer);

  g_wifi_enabled = true;
  Serial.printf("[bus] ready (espnow, no AP), node_id=0x%02X\n", node_id);
}

void bus_init_no_wifi(uint8_t node_id) {
  g_node_id = node_id;
  g_tx_mode = BUS_TX_CAN_ONLY;
  memset(g_dedup, 0, sizeof(g_dedup));
  g_ring_head = g_ring_tail = 0;
  Serial.printf("[bus] ready (can-only), node_id=0x%02X\n", node_id);
}

bool bus_tx(uint32_t id, const uint8_t* data, uint8_t dlc) {
  bool any_ok = false;

  // Wired CAN
  if (g_tx_mode != BUS_TX_WIFI_ONLY) {
    twai_message_t m = {};
    m.identifier = id;
    m.data_length_code = dlc;
    memcpy(m.data, data, dlc);
    if (twai_transmit(&m, pdMS_TO_TICKS(10)) == ESP_OK) {
      any_ok = true;
      g_last_can_tx_ok = millis();
      g_tx_fail_streak = 0;
    } else {
      if (++g_tx_fail_streak >= 5) {
        twai_clear_transmit_queue();
        g_tx_fail_streak = 0;
        Serial.println("[bus] TX queue flushed (no ACK)");
      }
    }
  }

  // ESP-NOW broadcast
  WifiFrame f;
  f.magic   = WIFI_FRAME_MAGIC;
  f.node_id = g_node_id;
  f.seq     = g_tx_seq++;
  f.can_id  = id;
  f.dlc     = dlc;
  memset(f.data, 0, 8);
  memcpy(f.data, data, dlc);

  dedup_seen_or_record(g_node_id, f.seq); // suppress our own echo if it wraps around

  if (g_wifi_enabled && g_tx_mode != BUS_TX_CAN_ONLY) {
    // Unicast (encrypted) to every peer we've already heard from.
    for (int i = 0; i < g_enc_count; i++)
      if (esp_now_send(g_enc_macs[i], (uint8_t*)&f, sizeof(f)) == ESP_OK) any_ok = true;
    // Broadcast (unencrypted) as discovery beacon for peers not yet contacted.
    uint8_t bcast[6]; memset(bcast, 0xFF, 6);
    if (esp_now_send(bcast, (uint8_t*)&f, sizeof(f)) == ESP_OK) any_ok = true;
  }

  // Feed our own outbound frames back into the rx ring so application
  // code (LCD updates, state mirrors) reacts to web-UI-sourced frames
  // the same way it reacts to frames from other nodes.
  {
    BusFrame ob = {};
    ob.id = id; ob.dlc = dlc;
    memcpy(ob.data, data, dlc);
    strncpy(ob.source, "self", sizeof(ob.source));
    ring_push(ob);
    if (g_observer) g_observer(ob, /*outbound=*/true);
  }

  return any_ok;
}

bool bus_rx(BusFrame& out) {
  if (g_ring_tail == g_ring_head) return false;
  out = g_ring[g_ring_tail];
  g_ring_tail = (g_ring_tail + 1) % RX_RING_SIZE;
  return true;
}

void bus_tick() {
  // Drain the TWAI driver into our ring
  twai_message_t rx;
  while (twai_receive(&rx, 0) == ESP_OK) {
    g_last_can_rx = millis();
    BusFrame b = {};
    b.id = rx.identifier;
    b.dlc = rx.data_length_code;
    memcpy(b.data, rx.data, rx.data_length_code);
    strncpy(b.source, "can", sizeof(b.source));
    ring_push(b);
    if (g_observer) g_observer(b, /*outbound=*/false);
  }
}

uint8_t bus_node_id()       { return g_node_id; }
bool bus_can_healthy()      { uint32_t n=millis(); return (n-g_last_can_rx)<5000 || (n-g_last_can_tx_ok)<2000; }
uint8_t bus_last_error_code() { return g_last_error_code; }

bool bus_twai_check() {
  twai_status_info_t info;
  if (twai_get_status_info(&info) != ESP_OK) return false;

  bool is_running  = (info.state == TWAI_STATE_RUNNING);
  bool is_bus_off  = (info.state == TWAI_STATE_BUS_OFF);
  bool is_err_pass = is_running &&
      (info.tx_error_counter >= 96 || info.rx_error_counter >= 96);

  Serial.printf("[twai] state=%d tx_err=%u rx_err=%u tx_failed=%u rx_missed=%u\n",
                info.state, info.tx_error_counter, info.rx_error_counter,
                info.tx_failed_count, info.rx_missed_count);

  // Determine the highest-priority current error.
  uint8_t new_err = 0;
  if (is_bus_off) {
    new_err = BUS_ERR_BUS_OFF;
    Serial.println("[bus] TWAI BUS_OFF — recovering");
    twai_initiate_recovery();
  } else if (is_err_pass) {
    new_err = BUS_ERR_ERROR_PASSIVE;
  } else {
    // Check cumulative counters for TX fail spike or RX overflow.
    if (info.tx_failed_count > g_last_tx_failed + 4)
      new_err = BUS_ERR_TX_FAIL;
    else if (info.rx_missed_count > g_last_rx_missed + 4)
      new_err = BUS_ERR_RX_OVERFLOW;
  }
  g_last_tx_failed = info.tx_failed_count;
  g_last_rx_missed = info.rx_missed_count;

  // Emit CAN_ID_BUS_ERROR only on transitions to avoid spamming every 2 s.
  if (new_err != 0 && new_err != g_last_error_code) {
    uint8_t d[4] = { g_node_id, new_err,
                     (uint8_t)info.tx_error_counter,
                     (uint8_t)info.rx_error_counter };
    bus_tx(CAN_ID_BUS_ERROR, d, 4);
    Serial.printf("[bus] BUS_ERROR emitted: code=%u tx_err=%u rx_err=%u\n",
                  new_err, info.tx_error_counter, info.rx_error_counter);
    // Also emit unified ERROR_EVENT so buzzer/LED/Cardputer react.
    uint8_t err_code = (new_err == BUS_ERR_BUS_OFF)       ? ERR_CAN_BUS_OFF :
                       (new_err == BUS_ERR_ERROR_PASSIVE) ? ERR_CAN_ERROR_PASSIVE :
                       (new_err == BUS_ERR_TX_FAIL)       ? ERR_CAN_TX_FAIL :
                                                           ERR_CAN_RX_OVERFLOW;
    uint8_t sev = (new_err == BUS_ERR_BUS_OFF) ? ERR_SEV_CRITICAL : ERR_SEV_WARNING;
    error_raise_local(err_code, sev, new_err);
  } else if (new_err == 0 && g_last_error_code != 0) {
    // Bus recovered — clear any active CAN error.
    uint8_t prev_code = (g_last_error_code == BUS_ERR_BUS_OFF)       ? ERR_CAN_BUS_OFF :
                        (g_last_error_code == BUS_ERR_ERROR_PASSIVE) ? ERR_CAN_ERROR_PASSIVE :
                        (g_last_error_code == BUS_ERR_TX_FAIL)       ? ERR_CAN_TX_FAIL :
                                                                       ERR_CAN_RX_OVERFLOW;
    error_clear(prev_code);
  }
  g_last_error_code = new_err;

  bool ok = (is_running && !is_err_pass);
  bool changed = (ok != g_twai_was_ok);
  g_twai_was_ok = ok;
  return changed;
}
bool bus_wifi_seen_peer()   { return g_wifi_enabled && (millis() - g_last_wifi_rx) < 5000; }
bool bus_twai_running()     { return g_twai_was_ok; }

uint8_t bus_peer_count() {
  uint32_t now = millis();
  uint8_t n = 0;
  for (int i = 0; i < 8; i++)
    if (g_peers[i].node_id && (now - g_peers[i].last_seen_ms) < PEER_TIMEOUT_MS) n++;
  return n;
}

uint8_t bus_get_peer_ids(uint8_t* out, uint8_t max) {
  uint32_t now = millis();
  uint8_t n = 0;
  for (int i = 0; i < 8 && n < max; i++) {
    if (g_peers[i].node_id && (now - g_peers[i].last_seen_ms) < PEER_TIMEOUT_MS)
      out[n++] = g_peers[i].node_id;
  }
  return n;
}

// Bitmask of active ESP-NOW peer node IDs seen within PEER_TIMEOUT_MS.
// Bit N is set if node 0xN has been heard from recently (nodes are 0x01-0x04).
uint8_t bus_peer_node_bitmap() {
  uint32_t now = millis();
  uint8_t bits = 0;
  for (int i = 0; i < 8; i++) {
    uint8_t nid = g_peers[i].node_id;
    if (nid && nid < 8 && (now - g_peers[i].last_seen_ms) < PEER_TIMEOUT_MS)
      bits |= (1u << nid);
  }
  return bits;
}
void     bus_set_tx_mode(BusTxMode mode) { g_tx_mode = mode; }
BusTxMode bus_get_tx_mode()              { return g_tx_mode; }
void bus_set_observer(bus_observer_t cb) { g_observer = cb; }

void bus_set_espnow_keys(const uint8_t pmk[16], const uint8_t lmk[16]) {
  memcpy(g_espnow_pmk, pmk, 16);
  memcpy(g_espnow_lmk, lmk, 16);
  g_espnow_keys_set = true;
}

// --------------------------------------------------------------
// LCD status widgets for CAN and WiFi health indicators
// --------------------------------------------------------------
#ifdef ENABLE_LCD

#ifndef BUS_CAN_WIDGET_ROW
#define BUS_CAN_WIDGET_ROW 0
#endif
#ifndef BUS_CAN_WIDGET_COL
#define BUS_CAN_WIDGET_COL 0
#endif
#ifndef BUS_ESPNOW_WIDGET_ROW
#define BUS_ESPNOW_WIDGET_ROW 0
#endif
#ifndef BUS_ESPNOW_WIDGET_COL
#define BUS_ESPNOW_WIDGET_COL 2
#endif
#ifndef BUS_AP_WIDGET_ROW
#define BUS_AP_WIDGET_ROW 0
#endif
#ifndef BUS_AP_WIDGET_COL
#define BUS_AP_WIDGET_COL 4
#endif

static void can_status_render(char* buf, uint8_t width) {
  buf[0] = 'C';
  if (width > 1) buf[1] = lcd_status_char(bus_can_healthy());
}

static void espnow_status_render(char* buf, uint8_t width) {
  buf[0] = 'N';
  if (width > 1) buf[1] = lcd_status_char(bus_wifi_seen_peer());
}

#if USE_WIFI
static void ap_status_render(char* buf, uint8_t width) {
  buf[0] = 'A';
  if (width > 1) buf[1] = lcd_status_char(WiFi.softAPIP() != IPAddress(0, 0, 0, 0));
}
#endif

void bus_register_lcd_widgets() {
  { LcdWidget w = { BUS_CAN_WIDGET_ROW, BUS_CAN_WIDGET_COL, 2, 1000, can_status_render }; lcd_register_widget(w); }
#if USE_WIFI
  { LcdWidget w = { BUS_ESPNOW_WIDGET_ROW, BUS_ESPNOW_WIDGET_COL, 2, 1000, espnow_status_render }; lcd_register_widget(w); }
  { LcdWidget w = { BUS_AP_WIDGET_ROW, BUS_AP_WIDGET_COL, 2, 1000, ap_status_render }; lcd_register_widget(w); }
#endif
}

#else
void bus_register_lcd_widgets() {}
#endif // ENABLE_LCD
