jcollinsnw/CANoE/(commit log)

2026-04-23 Working switch..
2026-04-25 Add LCD, relay module, other interfaces.
2026-04-26 LCD status overhaul, independent WiFi/ESP-NOW, buzzer improvements
    LCD:
    - Row 0 redesigned: C[x] N[x] A[x] (CAN / ESP-NOW / WiFi AP) + relay bitmap at cols 10-15
    - Three independent status indicators replace the old single WiFi icon
    - Relay widget drops brackets; relay chars right-aligned
    - Row 1 reserved for event text and menu only (RPM bar disabled until hardware ready)
    - LCD hard-reinit every 30 s recovers from HD44780 brownouts; CGRAM patterns
    stored for replay; I2C failure counter retained as fast-path trigger
    - menu_exit() clears both rows before redrawing to prevent menu text ghosting
    WiFi / ESP-NOW:
    - AP and ESP-NOW now independently controlled via ap_en / espnow_en NVS flags
    - N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
    [bus.cpp, bus.h, can_protocol.h, ecu_node.h, mod_buzzer.cpp, mod_buzzer.h, mod_ecu.cpp]
2026-04-27 Add ECU node: fuel control, network announce heartbeat, LCD peer names
    Firmware:
    - Add CAN_ID_NODE_ANNOUNCE (0x0F0): every node broadcasts [node_id, peer_count,
    can_ok] every 5 s so the Network tab and peer tables work bidirectionally
    - Increase PEER_TIMEOUT_MS 6000→12000 ms (tolerate one missed heartbeat)
    - LCD peer messages now show named nodes ("viper online", "relay offline",
    "2: relay viper") using bus_peer_node_bitmap() + __builtin_ctz/popcount
    - Add mod_ecu.h / mod_ecu.cpp: dual-mode fuel controller (carb PI solenoid +
    TBI dual injectors), VE table, CLT enrichment, STFT closed-loop from WBO2
    - Add mod_serial_shell.h / mod_serial_shell.cpp: serial CAN frame monitor
    - Add firmwa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
    [bus.cpp, bus.h, can_protocol.h, mod_buzzer.cpp, mod_buzzer.h, mod_lcd.cpp, mod_menu.cpp]
2026-04-27 Show unknown CAN nodes in Network tab
    Any device that joins the bus but isn't one of the four known nodes
    now appears in the Network tab:
    - bus_get_peer_ids(): new function returns all active ESP-NOW peer
    node IDs (not filtered to 0x01-0x04)
    - /api/status now includes peer_ids[] alongside peer_nodes bitmap
    - netObserve() records unrecognized CAN frame IDs into unknownFrameIds
    - renderNetwork() appends two new sections below known nodes:
    - Unknown nodes: amber cards for any node_id seen via announce or
    peer_ids that isn't in KNOWN_NODES
    - Foreign traffic: single amber card listing all unrecognized CAN
    frame IDs seen within NET_TTL (15 s)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
2026-04-27 Add runtime node ID reassignment via CAN
    CFG_KEY_NODE_ID (0x01): any node can reassign its own node_id over CAN.
    New ID is saved to NVS and the node restarts to apply it.
    - can_protocol.h: add CFG_KEY_NODE_ID 0x01
    - accessory_node.ino: read "node_id" from NVS at boot before bus_init();
    pass effective id to all webui_init/bus_init* calls instead of NODE_ID.
    Replace hardcoded NODE_ID in CONFIG_WRITE target check and announce
    payload with bus_node_id(). Add CFG_KEY_NODE_ID handler (broadcast
    target explicitly rejected to prevent all nodes reassigning to same ID).
    - web UI: Node Settings section in Control tab shows current ID with an
    input+Reassign button. Sends CONFIG_WRITE 0x400 fr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
    [can_protocol.h]
2026-04-27 Update CAN documentation
    README §15 (CAN Frame Reference):
    - Add NODE_ANNOUNCE (0x0F0) to frame table — was implemented but never documented
    - Expand into subsections: frame table, config protocol layout, ECU commands, raw examples
    - Config protocol: add full byte-offset table for CONFIG_WRITE payload
    - Config keys: add CFG_KEY_NODE_ID (0x01), CFG_KEY_WIFI/AP/ESPNOW_ENABLED (0x30-0x32)
    - Config targets: formatted as table with broadcast restriction note
    - Add §15.4 raw frame examples covering relay, viper, node ID reassignment,
    WiFi control, ECU tuning, RPM redline, relay safety timeout
    CLAUDE.md:
    - Add NODE_ANNOUNCE (0x0F0) to protocol table
    - Add all missing config keys: 0x01 NODE_I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
2026-04-27 Reconfigure switch panel: 3 switches + 7 buttons
    Reassign inputs from 6 latching/4 momentary to 3 latching/7 momentary.
    Named assignments: SW1=fuel pump (R2), SW2=choke (R3), BTN1=menu,
    BTN2=horn hold (R5), BTN3=headlights toggle (R1), BTN4=all off.
    Remaining 5 inputs spare. Add relay labels for LCD menu display.
2026-04-27 Remove custom relay icons, use default block/dash chars
    All relay labels kept; ON state uses \xFF full block, OFF uses '-'.
    Frees all 7 CGRAM slots and removes the 7-icon cap concern.
2026-04-29 Add bridge node: CAN-to-WiFi/MQTT gateway with node discovery UI
    - New bridge config (NODE_ID 0x05): SoftAP + wired CAN + STA to home router,
    no ESP-NOW (avoids channel conflict with STA)
    - NODE_CAP (0x0F2) / NODE_CAP_REQ (0x0F3) CAN frames: every node broadcasts
    capabilities (relay count, switch/button/LED counts, feature flags) at boot
    and every 30 s; responds to on-demand requests
    - webui: /api/nodecaps endpoint on all WiFi nodes; bridge web UI shows
    aggregated per-node control panels (relays, switches, buttons, viper, LEDs)
    built from live NODE_CAP data; Rules tab hidden on bridge
    - mod_mqtt: publishes CAN frames to {prefix}/frames, subscribes to
    {prefix}/send for frame injec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
    [bridge.h, can_protocol.h, mod_mqtt.cpp, mod_mqtt.h, webui.cpp, webui.h]
2026-04-29 Update docs for bridge node, NODE_CAP frames, and MQTT
    - CLAUDE.md: add bridge to node table; add BRIDGE_MODE/MQTT_BROKER flags;
    add 0x0F1/0x0F2/0x0F3 to CAN protocol table; update repo layout, build
    commands, web UI tab descriptions, /api/nodecaps and /api/config notes,
    BusFrame.source gotcha; mark bridge TODO done; add PubSubClient to libs
    - README.md: add 0x0F1/0x0F2/0x0F3 to CAN frame table; add bridge to
    config targets table; update make commands to short names + bridge target
    - can-bus-reference.md: add bridge to node ID table; add Node Management
    section covering NODE_ANNOUNCE, BOOT_EVENT, NODE_CAP, NODE_CAP_REQ
    with payload tables and examples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
2026-05-03 Add CAN reliability monitoring with error alerts
    - bus_twai_check() now detects bus-off, error passive (TEC/REC >= 96),
    TX fail spikes, and RX overflow; emits CAN_ID_BUS_ERROR (0x0F4) on
    transitions over both transports so ESP-NOW carries it even when
    wired CAN is failing
    - New rule actions: RULE_ACT_LED_FLASH (sends 4-byte LED_CMD flash mode)
    and RULE_ACT_BUZZER_ALERT (3-beep high-pitch warning tone)
    - New trigger macros: TRIG_BUS_ERROR(), TRIG_CAN_OK()
    - Switch panel default rules: BUS_ERROR flashes LED3 + plays alert;
    healthy NODE_ANNOUNCE clears LED3 within 5s of recovery
    - MAX_RULES bumped to 20 on switch panel to leave room for user rules
    - Web UI: BUS_ERROR frame and new act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
    [bus.cpp, bus.h, can_protocol.h, mod_buzzer.cpp, mod_buzzer.h, mod_rules.cpp, switch_panel.h]
2026-05-03 Split monolithic README into focused docs/ with per-module references
    Breaks the 1290-line README into a landing page plus topic documents
    under docs/ and docs/modules/, covering all 18 firmware modules with
    consistent enable/config/CAN-frames/integration-notes format.
2026-05-03 Remove stale WiFi-only persistence roadmap item
    The 3-mode TX system (CAN+WiFi / WiFi Only / CAN Only) already covers
    this. Persisting a non-default mode would be undesirable — WiFi-only
    is a testing tool that should reset on reboot.
2026-05-03 Remove unused legacy bus_set_wifi_only / bus_is_wifi_only wrappers
    These were never called — the 3-mode BusTxMode system (CAN+WiFi,
    WiFi Only, CAN Only) replaced them entirely.
    [bus.h]
2026-05-03 Add ESP Now encrytpion, switch ack, retry, error.
    [bus.cpp, can_protocol.h, mod_switches.cpp, mod_switches.h]
2026-05-03 Add BLE CAN mirror (mod_bluetooth) + iOS Tuner app
    - firmware/accessory_node/mod_bluetooth.h/.cpp: GATT server that
    notifies a phone of every CAN frame and accepts injected frames
    from the phone via write-without-response. Two custom characteristics
    (TX notify ACC00002, RX write ACC00003) under service ACC00001.
    32-slot TX ring (main task), 8-slot spinlock RX ring (BT→main).
    Re-advertises on disconnect; enabled with ENABLE_BLUETOOTH.
    - accessory_node.ino: add ENABLE_BLUETOOTH hooks in setup/loop/
    frame dispatch alongside ENABLE_WBO2.
    - tuner/: iOS 17 Swift app (Xcode project)
    BLEManager.swift — CoreBluetooth central, auto-reconnect via
    saved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
2026-05-03 docs: update CLAUDE.md and ROADMAP.md for ESP-NOW encryption, switch ACK/retry, and bus error monitoring
    - CAN protocol table: add BUS_ERROR (0x0F4) and SWITCH_ACK (0x202); expand LED_CMD entry for 4-byte flash form
    - Rules engine: add TRIG_BUS_ERROR, TRIG_CAN_OK, TRIG_BOOT, ACT_LED_FLASH, ACT_BUZZER_ALERT
    - Switch module: document ACK/retry mechanism (3 retries, 80ms, buzzer+LED on timeout)
    - Conventions: replace Open AP note with secrets.h pattern; add ESP-NOW encryption note
    - Architecture: update SoftAP and wire-failure test descriptions for 3-mode TX and secrets.h
    - Repo layout: add secrets.h and secrets.h.example entries
    - Known TODO: mark SoftAP password, ESP-NOW encryption, and switc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
2026-05-03 Multiplatform iOS + macOS support for Tuner app
    Source-level platform guards so the same Swift files compile for
    both iOS 17+ and macOS 14+ using a single Xcode target.
    NodeWebView.swift:
    - Rewrite as struct with conditional extensions:
    UIViewRepresentable (iOS) / NSViewRepresentable (macOS)
    - Shared WebErrorView (SwiftUI, works on both platforms)
    - Error overlay via UIHostingController.view (iOS) or
    NSHostingView (macOS) — both backed by the same SwiftUI view
    - Pull-to-refresh guarded to #if canImport(UIKit)
    - Associated-object pattern keeps UIHostingController alive on iOS
    BLEManager.swift:
    - CBCentralManagerOptionRestoreIdentifierKey and willRestoreState
    delega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
    [bus.cpp, bus.h, can_protocol.h, mod_blob.cpp, mod_blob.h, mod_buzzer.cpp, mod_buzzer.h]
2026-05-03 docs: update all docs for reboot command, blob protocol, WiFi credentials, SoftAP notifications
    can-bus-reference.md:
    - Add BUS_ERROR (0x0F4) and REBOOT_CMD (0x0F5) under Node Management
    - Add SWITCH_ACK (0x202) under Switch Events
    - Add Blob Transfer section (BLOB_WRITE 0x410, BLOB_COMMIT 0x411, BLOB_NS_WIFI)
    - Add WiFi Credentials section with REST API and CAN blob approach
    web-console.md:
    - Document WiFi Credentials panel in Settings (Load/Save/Broadcast/Reboot All)
    docs/modules/menu.md:
    - Add MENU_HAS_REBOOT config define and REBOOT_CMD to CAN frames table
    - Add Reboot submenu to menu structure diagram
    docs/modules/webui.md:
    - Add /api/wifi_creds GET/POST and /api/wifi_creds/reset end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
2026-05-03 feat: BUZZER_CMD CAN frame, rules-over-CAN blob audit, ECU v3.x fix
    - Add CAN_ID_BUZZER_CMD (0x104): any node can target a buzzer by node ID
    or broadcast (0xFF); BUZZER_SEQ_* and BUZZER_CMD_MUTE constants defined
    - buzzer_handle_frame() responds to 0x104 in addition to existing RELAY_CMD
    - RULE_ACT_BUZZER_PLAY sends a BUZZER_CMD frame through CAN (targetable,
    log-visible); RULE_ACT_BUZZER_ALERT still fires locally for urgency
    - Rules HTTP endpoints (POST/DELETE/reset) now emit BLOB_NS_RULES (0x02)
    frames so every rule change appears in the CAN frame log
    - accessory_node.ino blob commit callback handles BLOB_NS_RULES: applies
    rules_set/rules_clear/rules_reset_factory locally
    - Fix ECU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
    [can_protocol.h, mod_buzzer.cpp, mod_ecu.cpp, mod_rules.cpp, webui.cpp]
2026-05-03 feat(wbo2): EMA filter opt-in, signal integrity docs, off-brand LSU 4.9 notes
    - Add WBO2_EMA_ALPHA: exponential moving average across readings, compiled
    out by default (omit define = no filter, no overhead)
    - Docs: signal integrity section with divider resistor sizing, RC filter
    schematic, shielded wire guidance, and ground reference advice
    - ROADMAP: update wideband item to reflect LSU 4.9 + bare controller plan
2026-05-03 docs: ethernet power topology, redundant 5V design, WBO2 controller notes
    Document dual-battery wiring over Cat5e pairs, redundant buck converter
    5V rail with ORing diode TODO, relay load fuse block layout, and
    off-brand LSU 4.9 controller calibration notes with ADC oversampling.
2026-05-03 chore: move images to assets/, switch README logo to canoe.png
2026-05-03 feat(shell): console-like serial shell with aliases and make screen target
    Add prompt, local echo, backspace, and monitor frame interleaving to the
    serial shell. Port web UI aliases (:relay, :alloff, :horn, :viper) so the
    shell accepts the same shorthand commands. Add `make screen` target which
    opens the port with screen(1) for correct character-at-a-time input.
    [mod_serial_shell.cpp]
2026-05-16 feat: add mod_battery, mod_channels, M5 Cardputer integration, and tuner app updates
    - mod_battery: dual-channel battery voltage ADC module; broadcasts
    CAN_ID_TELEMETRY (0x300). Enabled on switch panel (GPIO 36/39),
    disabled on relay controller.
    - mod_channels: channel capability discovery (CHAN_CAP_REQ 0x320 /
    CHAN_CAP 0x321) so nodes advertise what data they publish.
    - mod_m5_cardputer: M5Stack Cardputer (ESP32-S3) integration as a
    portable CAN terminal with TFT display, keyboard CLI, relay status
    bar, frame log, and hotkey relay control.
    - configs/cardputer.h: new node config (NODE_ID 0x06, ESPNOW_ONLY,
    CAN on GPIO 1/2).
    - Makefile: add cardputer compile/upload targets using m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
2026-05-16 feat: BLE CAN commands, Cardputer UI polish, CLI history, Makefile UF2 deploy
    - mod_bluetooth: CFG_KEY_BT_ENABLED (0x33) saves bt_en to NVS and restarts;
    CFG_KEY_BT_ADVERTISING (0x34) toggles advertising at runtime without restart;
    both handled in bluetooth_handle_frame() so they only compile with ENABLE_BLUETOOTH
    - relay_controller.h: add ENABLE_BLUETOOTH
    - can_protocol.h: document new keys 0x33 / 0x34
    - mod_m5_cardputer: STATUS_BAR_H 25→22 (relay boxes centred, 4 px margin each side);
    status bar fill NAVY→ACAPULCO_BLUE (#006DAC, RGB565 0x0375); FEED/MENU label
    y-position uses (STATUS_BAR_H-8)/2 for proper vertical centering
    - mod_m5_cardputer: CLI bar shows status events (yello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
2026-05-16 docs: update CAN reference, bluetooth module, and build guide
    - docs/can-bus-reference.md: add cardputer (0x06) to Node IDs table;
    add CFG_KEY_BT_ENABLED (0x33) and CFG_KEY_BT_ADVERTISING (0x34)
    sections with example frames
    - docs/modules/bluetooth.md: add Runtime control via CAN table and
    examples for keys 0x33 / 0x34
    - docs/build.md: fix upload-cardputer — now UF2 mass-storage deploy,
    not serial; document G0 boot mode and configurable volume/path
2026-05-16 feat(cardputer): status bar nav, CAN/FEED/MENU screens, BLE CAN commands
    - Add opt-key status bar selection mode: navigate relay boxes and
    screen label with ;/., toggle relays with Enter/Space, switch
    screens via dropdown (CAN / FEED / MENU)
    - Add FEED screen: human-readable decoded frame log (separate buffer
    from CAN raw hex log; both fill simultaneously)
    - decode_frame() covers NODE_ANNOUNCE, BOOT, BUS_ERROR, RELAY_CMD/STATUS,
    SWITCH_EVENT, ENCODER_EVENT, TELEMETRY, ENGINE_DATA, GPS_DATA,
    WBO2_DATA, ECU_DATA, VIPER_CMD, CONFIG_WRITE, REBOOT_CMD
    - Rename FEED→CAN screen, add new FEED screen with its own scroll buffer
    - Add CFG_KEY_BT_ENABLED (0x33) and CFG_KEY_BT_ADVERTISING (0x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
    [cardputer.h, mod_buzzer.cpp, mod_m5_cardputer.cpp, mod_m5_cardputer.h, mod_menu.cpp, mod_switches.cpp, mod_switches.h, switch_panel.h]
2026-05-16 feat(cardputer): I2S speaker alerts, UI click sounds, peer count circle
    - Replace ENABLE_BUZZER (passive piezo, wrong hardware) with I2S speaker
    functions via M5Cardputer.Speaker: m5_beep_startup, m5_beep_alert,
    m5_beep_can_up, m5_beep_can_down, m5_beep_peer
    - Wire speaker calls into accessory_node.ino at the same points that
    drive buzzer_* on other nodes; extend relay-cmd deadline guard to
    (ENABLE_BUZZER || ENABLE_M5_CARDPUTER) so Cardputer gets the
    relay-controller-offline alert too
    - Add m5_ui_click() (4200 Hz, 30 ms) fired on every navigation and
    selection action: fn/ctrl mode toggles, status bar ;;/. nav, relay
    activate, dropdown confirm, menu scroll, menu enter, relay hot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
    [mod_m5_cardputer.cpp]
2026-05-17 feat(cardputer): COMMANDS+SETTINGS screens; fix OTA/WiFi creds recovery
    Cardputer UI
    - Rename MENU screen to COMMANDS (display + dropdown label; internal
    M5Screen::MENU enum kept). Status-bar label box widened to 56 px and
    relay tiles shifted to fit "COMMANDS"/"SETTINGS".
    - Add SETTINGS screen as the fourth dropdown entry: BT enable (target
    relay_controller via CFG_KEY_BT_ENABLED), WiFi enable (broadcast
    CFG_KEY_WIFI_ENABLED), speaker volume (5 steps, persisted to
    Preferences "m5card" / "spk_vol"). Speaker volume now controls
    m5_ui_click() output.
    - When opt enters status-bar selection, default focus is the screen
    label item so one Enter opens the screen-switch dropdown.
    Relia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
    [mod_m5_cardputer.cpp, mod_wifi_creds.cpp, switch_panel.h]
2026-05-17 feat(cardputer): two-tone peer join/leave with directional pitch
    m5_beep_peer now plays an ascending 660->990 Hz on join and a
    descending 990->440 Hz on leave instead of a single tone, so peer
    churn is audible at a glance. Volume bumped to 180 for audibility
    in the car. Edge detection via a static prev counter.
2026-05-17 build: Makefile precheck for missing secrets.h and M5Cardputer lib
    Compiler errors for missing setup files are cryptic ("fatal error:
    secrets.h: No such file" / "M5Cardputer.h: No such file") and don't
    tell a new clone what to do. Add three small targets:
    - check-secrets: enforces firmware/accessory_node/secrets.h exists,
    prints the exact "cp secrets.h.example secrets.h" command if not.
    Wired as a prereq of relay/switch/viper/ecu/bridge/cardputer.
    - check-lib-m5cardputer: verifies the M5Cardputer Arduino library is
    installed; prints the arduino-cli lib install command if not. Prereq
    of the cardputer target only.
    - check-lib-pubsub: only invoked from bridge when MQTT_BROKER is
    defi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
2026-05-17 fix(cardputer): open screen dropdown on opt; stop frames from wiping it
    Two small UX fixes:
    1. Pressing opt now opens the screen-switch dropdown directly instead
    of focusing the screen-label item and requiring a second Enter.
    That's almost always what opt is used for. Relay-tile navigation
    is still reachable: press del to dismiss the dropdown without
    leaving selection mode, then ;/. moves through the tiles.
    2. The dropdown was getting wiped within milliseconds of opening on a
    busy bus. redraw_can() / redraw_feed() (called from print_can /
    print_feed for every incoming frame) fill the y=23..73 region —
    the same region the dropdown is drawn over. Gate those repaints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
    [mod_m5_cardputer.cpp]
2026-05-17 feat(ble): swap to NimBLE, re-enable BLE on switch panel, fix menu toggle
    mod_bluetooth.cpp now uses NimBLE-Arduino 2.x instead of the heavy
    Bluedroid BLE stack. NimBLE uses ~50% less flash and ~100 KB less RAM,
    and crucially has much better WiFi+BLE coexist on ESP32-WROOM. The
    public API (bluetooth_setup/loop/handle_frame/set_advertising) is
    unchanged so callers don't need to know. Wire format and UUIDs are
    identical, so the iOS Tuner is unaffected.
    Concrete changes:
    - mod_bluetooth.cpp: rewritten against NimBLE. NimBLE 2.x callback
    signatures (onConnect/onDisconnect take NimBLEConnInfo&; onWrite
    takes NimBLEConnInfo&). NIMBLE_PROPERTY:: flags. CCCD descriptor
    added automatically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
    [mod_bluetooth.cpp, mod_menu.cpp, switch_panel.h]
2026-05-17 build(cardputer): switch to huge_app partition (89% → 37% flash usage)
    The Cardputer has 8 MB flash + 8 MB PSRAM, but the m5stack:esp32:
    m5stack_cardputer default board variant uses a 4 MB partition scheme
    that only gives 1.2 MB to the app — wasting half the chip and pushing
    us to 89% flash usage. We don't OTA the Cardputer (it flashes via UF2
    mass-storage), so huge_app's "3 MB app / 1 MB SPIFFS / no OTA" layout
    is the right pick. Drops the build to 37% (1.17 MB of 3 MB).
    Same binary, no code changes. ~2 MB of headroom for new features.
2026-05-17 refactor: rename accessory_node to canoe, flatten firmware/ dir, canoe-<role>.bin output
    Folder layout
    - firmware/accessory_node/ -> canoe/ at repo root (drops the firmware/ wrapper
    so the sketch lives one level shallower; Arduino convention requires the
    .ino filename to match the folder name, so accessory_node.ino -> canoe.ino).
    - firmware/configs/ -> configs/ at repo root, sibling to canoe/.
    - All path references in source comments, configs, docs/*.md, README, ROADMAP,
    CLAUDE.md tree, .gitignore, and Makefile updated to match.
    Build output
    - build/canoe-<role>.bin is now the single file you upload via the web UI or
    OTA. One name per role: canoe-relay, canoe-switch, canoe-viper, ca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
2026-05-28 feat(relay): RPM + coil sense + multi-gate fuel pump safety, Cardputer OTA
    Adds RPM-gated and coil-voltage-gated fuel pump cycling on the relay
    controller to prevent the dead-head failure mode that burned out the OEM
    pump after key-out parking with the chassis-ground master switch on.
    - mod_ignition reads coil + through a 5.545:1 divider on GPIO 39 with
    hysteresis (6.00 V / 4.00 V); broadcasts CAN_ID_IGNITION_DATA (0x310)
    - mod_fuel_pump owns R1 with a PRIME -> ARMED -> RUNNING FSM. Modes
    (FP_MODE_OFF/RPM/COIL/BOTH) selectable via CFG_KEY_FUEL_PUMP_SAFETY
    (0x61) or ACT_FUEL_PUMP_SAFETY_* rule actions. Default BOTH (strictest).
    - Adds CAN_ID_FUEL_PUMP_STATE (0x311) + BUZZER_SEQ_FUEL_PU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
    [can_protocol.h, canoe.ino, cardputer.h, mod_buzzer.cpp, mod_buzzer.h, mod_fuel_pump.cpp, mod_fuel_pump.h]
2026-05-28 refactor(fuel_pump): fold mod_ignition into mod_fuel_pump
    The ignition coil voltage sensing only existed to feed the fuel pump
    safety FSM, and both modules ran on the same node. Splitting them into
    producer/consumer modules connected by self-echoed IGNITION_DATA frames
    added complexity without any real decoupling — there was no scenario
    where one was useful without the other.
    - canoe/mod_ignition.{cpp,h} deleted; ADC sampling, hysteresis, and the
    IGNITION_DATA broadcast moved into mod_fuel_pump.cpp under
    IGN_COIL_ADC_PIN guards. The FSM now reads coil state directly from
    internal variables instead of round-tripping through CAN.
    - IGNITION_DATA (0x310) is still broadcast on coil edge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
2026-05-28 feat: unified ERROR_EVENT (0x0F6) protocol
    Add mod_error module implementing a J1939-inspired unified error system:
    - ERROR_EVENT frame with source, code, severity, flags, and args
    - 21 error codes grouped by subsystem (bus, power, engine, sensors, comms, app)
    - Severity-based hardware reactions (buzzer, LEDs, Cardputer alerts)
    - Rate limiting (1 frame/code/sec), 8-slot active error table
    - Auto-clear for non-latching errors (10s), latching until explicit clear
    - Rule trigger macros: TRIG_ERROR_EVENT, TRIG_ERROR_CRITICAL, TRIG_ERROR_EMERGENCY
    Integrated into all modules replacing ad-hoc buzzer/LED error signaling:
    - mod_relay: watchdog cutoff → ERR_RELAY_WATCHDOG (CRITICAL)
    - mod_fuel_pum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
    [bus.cpp, can_protocol.h, canoe.ino, mod_battery.cpp, mod_ecu.cpp, mod_error.cpp, mod_error.h]
